Dolphin-Labs/BD-001-Hachimaru-Documentation/Hardware/BD-001-Rev-3-Schematic.pdf

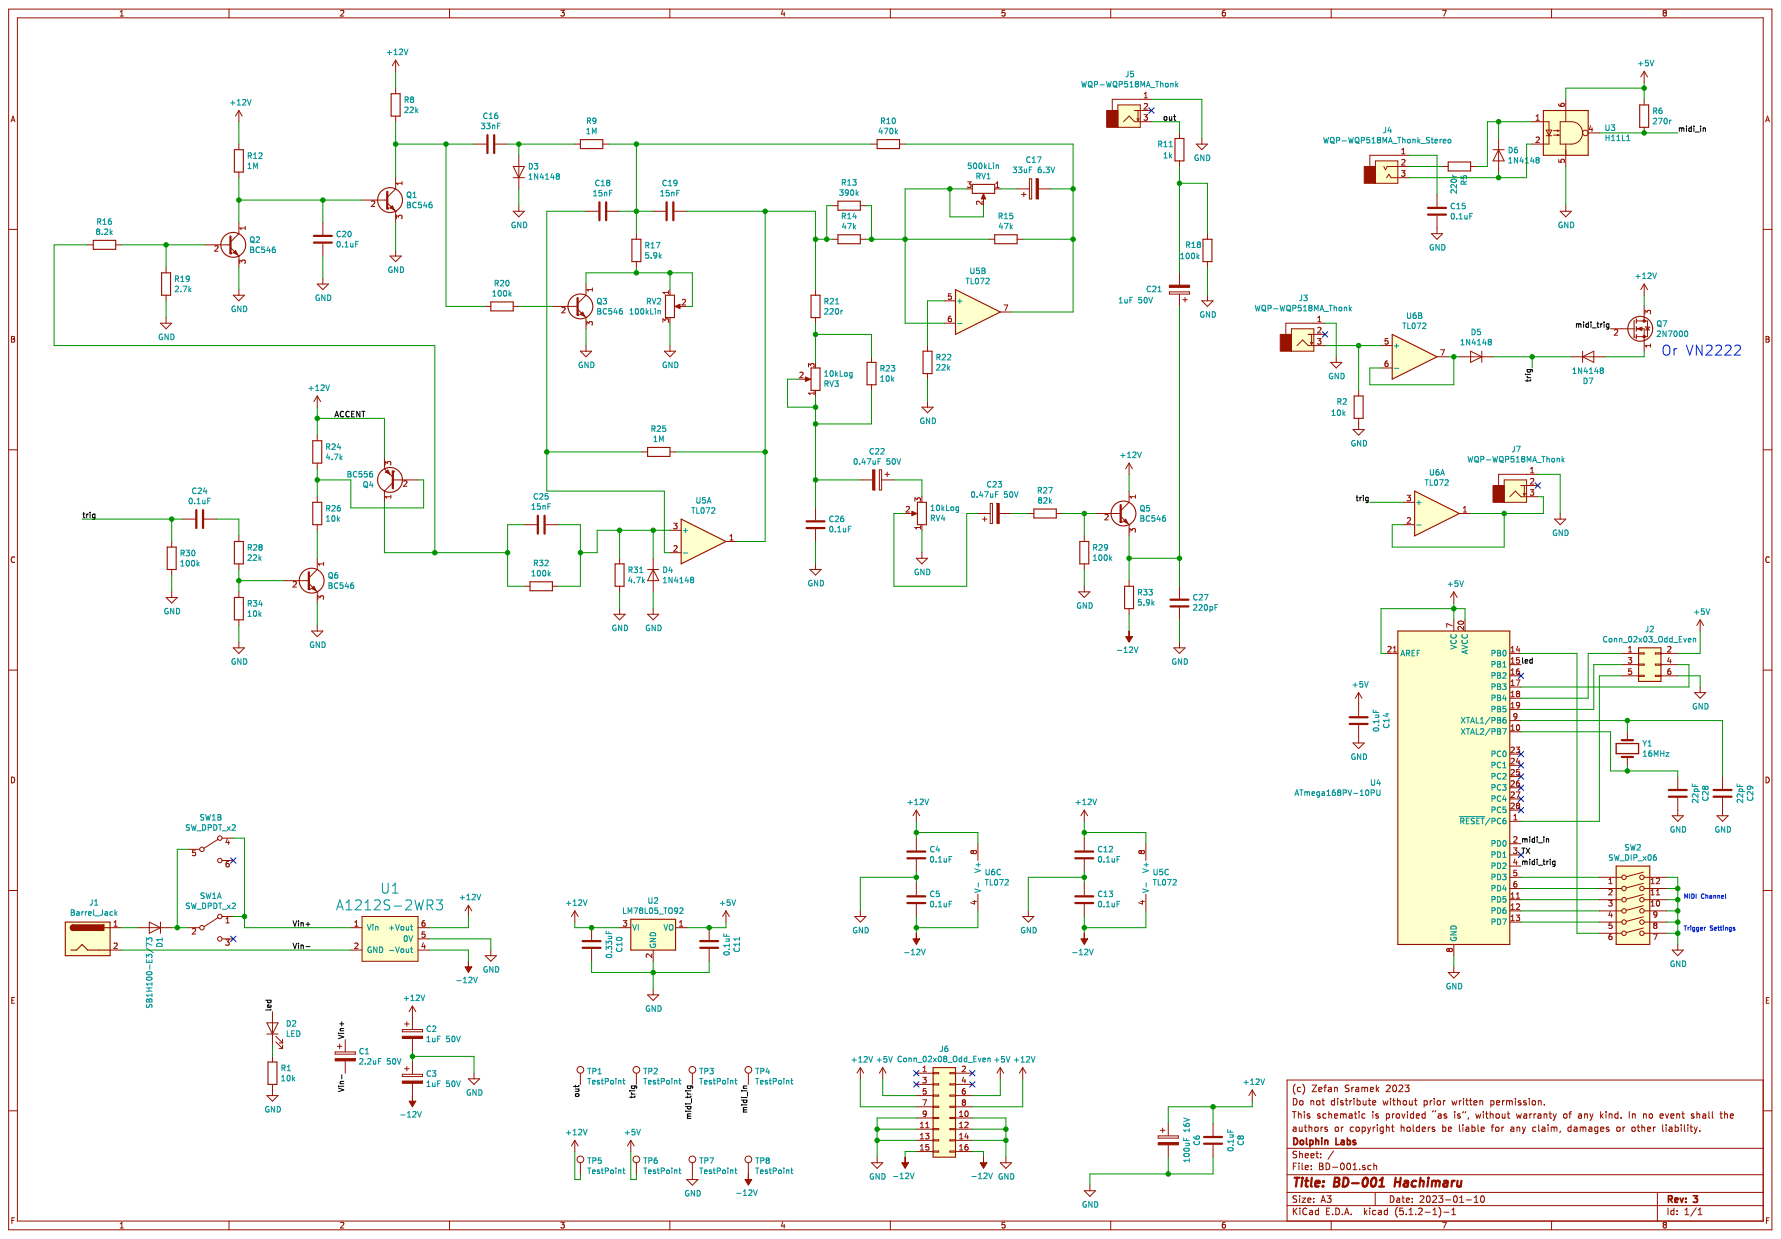
[picture p1: page 1]
